mehmetalperuslu/MAXTENS/MaxTENS.step

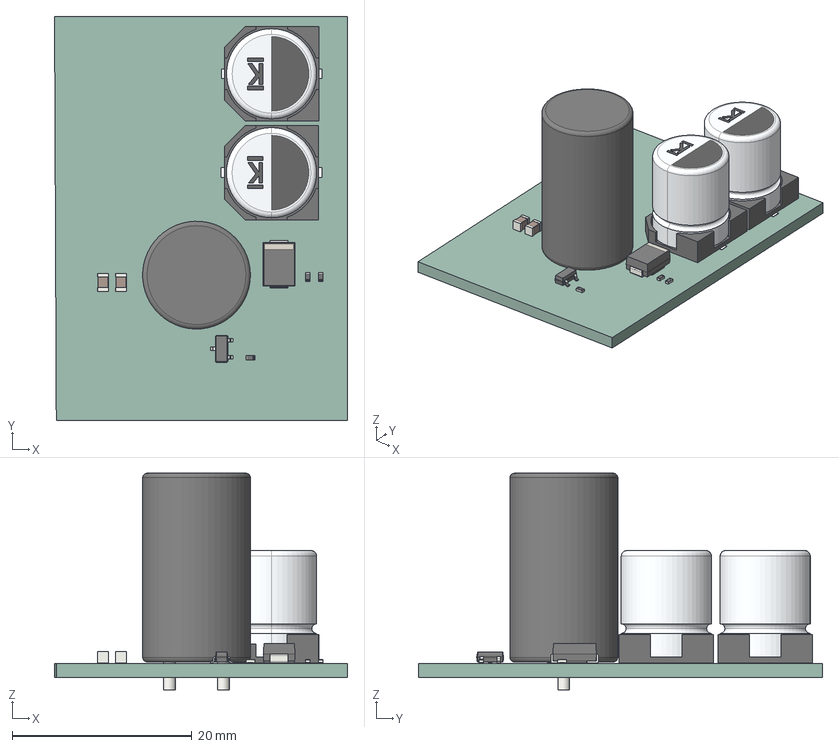
[picture p1: CAD file, 2023-09-30]
MaxTENS.step
32.6 x 45.0 x 24.1 mm
MaxTENS PCB
