mehmetalperuslu/MAXTENS/MaxTENS.kicad_pcb

## KiCad design MaxTENS.kicad_pcb (2024-05-13)

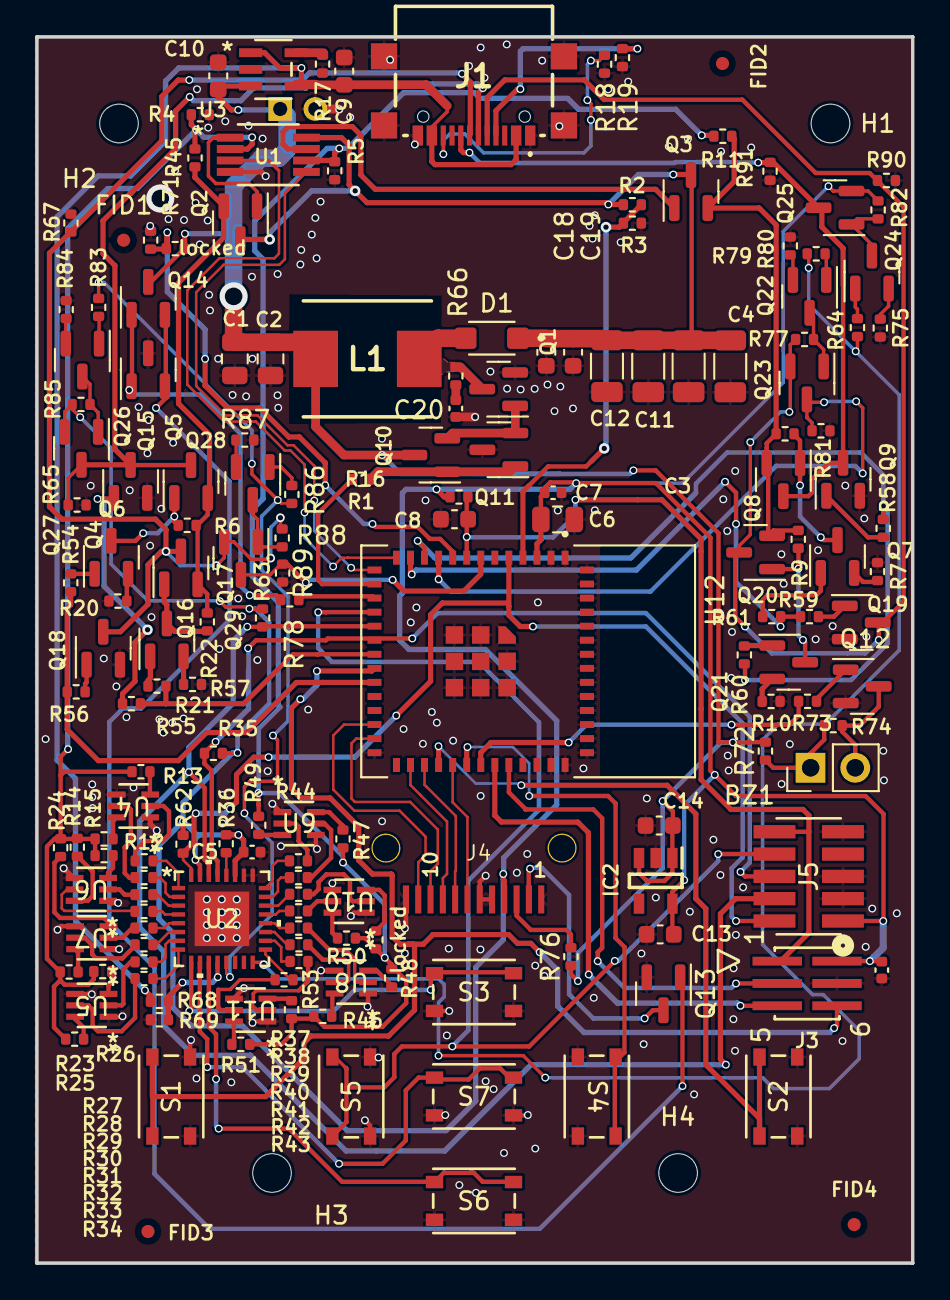
[picture p2: board MaxTENS.kicad_pcb from above]

Board: 2 copper layers, 49.9 x 69.8 mm, 174 parts (1 on the bottom side), 140 nets.

Parts:
BZ1: Buzzer; PinHeader_1x02_P2.54mm_Vertical
C1, C2: 10uF; C_0805_2012Metric
C3, C4, C11, C12: 2.2u; C_1206_3216Metric
C5, C7, C15, C20: 0.1u; C_0402_1005Metric
C6: 22u; C_0805_2012Metric
C8, C9, C10, C13, C14: 1u; C_0603_1608Metric
C18: 0.1u; C_0603_1608Metric
C19: 10n; C_0603_1608Metric
D1: DSS18UTR; SODFL3618X110N
FID1, FID2, FID3, FID4: Fiducial; Fiducial_0.75mm_Mask1.5mm
H1, H2, H3, H4: MountingHole; MountingHole_2.2mm_M2
IC2: AP7366-33W5-7; SOT95P285X130-5N
J1: GSB1C41110SSHR
J3: 20021121-00006C4LF; CONN_20021121-00006C4LF_AMP
J4: Conn_01x12; FPC_TFT_LCD
J5: 20021121-00010C4LF; CONN_00010C4LF_AMP
J6: Conn_01x02_Pin; PinHeader_1x02_P2.00mm_Vertical
L1: 22uH; INDPM7366X300N
Q1: PMV37ENEAR; SOT-23
Q2, Q3, Q4, Q6, Q7, Q9, Q10, Q12, Q14, Q16, Q18, Q19, Q21, Q22, Q24, Q26, Q28: NPN; SOT-23
Q5, Q8, Q11, Q15, Q17, Q20, Q23, Q25, Q27, Q29: PNP; SOT-23
Q13: T2N7002BK,LM; SOT-23
R1, R78: 100; R_0402_1005Metric
R2: 200k; R_0402_1005Metric
R3, R13, R16, R35, R36, R49, R62, R63, R66, R68, R69, R81, R89: 10k; R_0402_1005Metric
R4, R5: 30k; R_0402_1005Metric
R6, R8, R9, R22, R71, R77, R82, R85, R88: 100k; R_0402_1005Metric
R7, R10, R20, R21, R75, R80, R84, R87: 1k; R_0402_1005Metric
R11, R45: 16k; R_0402_1005Metric
R12, R47, R65, R67, R90, R91: 1M; R_0402_1005Metric
R14, R50: 4.99k; R_0402_1005Metric
R15: 3.3k; R_0402_1005Metric
R17, R24, R48: 2k; R_0402_1005Metric
R18, R19: 2.2k; R_0402_1005Metric
R23, R46: 2.4k; R_0402_1005Metric
R25, R51: 1.43k; R_0402_1005Metric
R26, R53: 1.1k; R_0402_1005Metric
R27, R28, R29, R30, R31, R32, R33, R34, R37, R38, R39, R40, R41, R42, R43, R44: 510; R_0402_1005Metric
R54, R55, R56, R57, R58, R59, R60, R61, R64, R79, R83, R86: 300; R_0402_1005Metric
R72, R73, R74: 1K; R_0402_1005Metric
R76: 10; R_0402_1005Metric
S1, S2, S3, S4, S5, S6, S7: PTS815 SJM 250 SMTR LFS; SW4_PTS815 SJM 250 SMTR LFS_CNK
U1: ADA4522-2ARMZ-R7
U2: PCAL6524HEAZ; HUQFN32_PCAL6524_NXP
U3: MCP73812T-420I/OT; SOT-23-5_MC_MCH
U4, U5, U6, U7, U8, U9, U10, U11: 2N7002KDW_R1_00001; SOT-363-6_2P2X1P35_ONS
U12: ESP32-MINI-1-N4; XCVR_ESP32-MINI-1-N4
locked: 3.3k; R_0402_1005Metric
locked#2: 33k; R_0402_1005Metric

Connections:
+3.3V: C5.2, C6.1, C7.1, C13.1, C15.2, IC2.5 (OUT), J3.1, J4.4, J5.1, Q25.2 (E), Q27.2 (E), R16.1, R35.1, R36.1, R62.1, R63.1, R82.2, R85.2, U2.27 (VDD(P)), U2.31 (VDD(I2C-BUS)), U12.3 (3V3)
+5V: C9.1, J1.A4 (VBUS_1), J1.A9 (VBUS_2), R68.2, U3.1 (CE), U3.4 (VDD)
+BATT: C1.1, C2.1, C10.1, C14.1, IC2.1 (IN), IC2.3 (EN), J6.1, L1.1, Q10.3 (C), Q14.3 (C), R72.2, R76.1, U3.3 (VBAT), locked#2.2
+OUT_1: Q2.2 (E), Q5.2 (E), Q17.2 (E), R6.2, R22.2, R45.1
+OUT_2: Q3.2 (E), Q8.2 (E), Q20.2 (E), R8.2, R9.2, R11.2
/BatteryCharger/BAT_CHG: R68.1, R69.2, U2.12 (P1_3)
/BatteryCharger/BAT_LEVEL: R71.2, U12.9 (I34), locked#2.1
/BatteryCharger/CH1_N: J1.A7 (DN1), Q17.3 (C), Q18.3 (C), Q29.2 (E), R67.1, R88.2
/BatteryCharger/CH1_P: J1.A6 (DP1), Q4.3 (C), Q5.3 (C), Q27.3 (C), R65.1
/BatteryCharger/CH2_N: J1.B7 (DN2), Q19.3 (C), Q20.3 (C), Q23.2 (E), R77.2, R90.1
/BatteryCharger/CH2_P: J1.B6 (DP2), Q8.3 (C), Q9.3 (C), Q25.3 (C), R91.1
/BoostConverter/VFB: R2.2, R3.1, U12.4 (I36)
/BoostConverter/VSW: R1.1, U12.15 (IO27)
/ElectrodeChannels/CH1_1: R55.2, R57.2, U12.20 (IO2)
/ElectrodeChannels/CH1_2: R54.1, R56.1, U12.22 (IO4)
/ElectrodeChannels/CH1_EL_DET: R83.1, R86.1, U2.13 (P1_4)
/ElectrodeChannels/CH2_1: R58.2, R60.2, U12.11 (IO32)
/ElectrodeChannels/CH2_2: R59.1, R61.1, U12.12 (IO33)
/ElectrodeChannels/CH2_EL_DET: R64.1, R79.1, U2.16 (P1_7)
/ElectrodeChannels/EL1_DET: Q29.3 (C), R89.1, U12.7 (I39)
/ElectrodeChannels/EL2_DET: Q23.3 (C), R81.1, U12.10 (I35)
/LCD/CLK: J4.9, U12.29 (IO5)
/LCD/CS: J4.8, U12.30 (IO18)
/LCD/DC: J4.7, U12.32 (IO19)
/LCD/DIN: J4.10, U12.26 (IO10)
/LCD/LCD_A: J4.3, R76.2
/LCD/LCD_BL: R78.1, U12.16 (IO14)
/LCD/LCD_K: J4.2, Q13.3 (D)
/LCD/RST: J4.11, U12.25 (IO9)
/MCU/BUZZER_MCU: R73.2, U12.34 (IO21)
/MCU/BUZZER_N: BZ1.2 (+), Q12.3 (C), R74.1
/MCU/BUZZER_P: BZ1.1 (-), R72.1, R74.2
/MCU/CH1_BTN: J3.5, S1.1, S1.2, U12.21 (IO0)
/MCU/CH2_BTN: S2.1, S2.2, U12.31 (IO23)
/MCU/EN: C8.2, J3.2, J5.10, R16.2, U12.8 (EN)
/MCU/IN1: U1.5 (INB+), U12.14 (IO26)
/MCU/IN2: U1.3 (INA+), U12.13 (IO25)
/MCU/INT_IO_EXP: J5.2, R62.2, U2.32 (*INT), U12.5 (I37)
/MCU/LEFT_BTN: S4.1, S4.2, U12.33 (IO22)
/MCU/MOSI: J5.4, R63.2, U2.30 (SDA), U12.18 (IO13)
/MCU/RIGHT_BTN: J5.8, S5.1, S5.2, U12.17 (IO12)
/MCU/RXD: J3.6, U12.35 (RXD0)
/MCU/SCK: J5.6, R35.2, U2.29 (SCL), U12.19 (IO15)
/MCU/TXD: J3.4, U12.36 (TXD0)
/Opamp/MODE_BTN: S6.1, S6.2, U2.11 (P1_2)
/Opamp/OK_BTN: S7.1, S7.2, U2.10 (P1_1)
/Opamp/OUTA: Q2.1 (B), U1.1 (OUTA)
/Opamp/OUTB: Q3.1 (B), U1.7 (OUTB)
/Opamp/P0W: R4.1, R12.1, R13.1, R14.1, R15.1, R23.1, R24.1, R25.1, R26.1, R45.2, U1.2 (INA-)
/Opamp/P1W: R5.1, R11.1, R46.1, R47.1, R48.1, R49.1, R50.1, R51.1, R53.1, U1.6 (INB-), locked.1
/Opamp/P05V: R27.1, U4.2 (G)
/Opamp/P010: R28.1, U4.5 (G)
/Opamp/P015: R29.1, U6.2 (G)
/Opamp/P15V: R37.1, U9.2 (G)
/Opamp/P020: R30.1, U6.5 (G)
/Opamp/P025: R31.1, U7.2 (G)
/Opamp/P030: R32.1, U7.5 (G)
/Opamp/P040: R33.1, U5.2 (G)
/Opamp/P050: R34.1, U5.5 (G)
/Opamp/P110: R38.1, U9.5 (G)
/Opamp/P115: R39.1, U10.2 (G)
/Opamp/P120: R40.1, U10.5 (G)
/Opamp/P125: R41.1, U8.2 (G)
/Opamp/P130: R42.1, U8.5 (G)
/Opamp/P140: R43.1, U11.2 (G)
/Opamp/P150: R44.1, U11.5 (G)
/Opamp/TIMER_BTN: S3.1, S3.2, U2.9 (P1_0)
GND: C1.2, C2.2, C3.2, C4.2, C5.1, C6.2, C7.2, C8.1, C9.2, C10.2, C11.2, C12.2, C13.2, C14.2, C15.1, C18.2, C19.2, C20.1, IC2.2 (GND), J1.A1 (GND_1), J1.A12 (GND_2), J1.MP1, J1.MP2, J1.MP3, J1.MP4, J3.3, J4.1, J4.5, J4.6, J4.12, J5.3, J5.5, J5.9, J6.2, Q1.2 (S), Q4.2 (E), Q9.2 (E), Q11.3 (C), Q12.2 (E), Q13.2 (S), Q15.3 (C), Q18.2 (E), Q19.2 (E), R3.2, R4.2, R5.2, R7.2, R10.2, R17.2, R18.1, R19.2, R20.2, R21.2, R65.2, R67.2, R69.1, R71.1, R75.2, R80.2, R81.2, R84.2, R87.2, R89.2, R90.2, R91.2, S1.3, S1.4, S2.3, S2.4, S3.3, S3.4, S4.3, S4.4, S5.3, S5.4, S6.3, S6.4, S7.3, S7.4, U1.4 (V-), U2.25 (VSS), U2.26 (ADDR), U2.33 (EP), U3.2 (VSS), U4.1 (S), U4.4 (S), U5.1 (S), U5.4 (S), U6.1 (S), U6.4 (S), U7.1 (S), U7.4 (S), U8.1 (S), U8.4 (S), U9.1 (S), U9.4 (S), U10.1 (S), U10.4 (S), U11.1 (S), U11.4 (S), U12.1 (GND_1), U12.2 (GND_1__1), U12.27 (GND_1__2), U12.38 (GND_1__3), U12.39 (GND_1__4), U12.40 (GND_1__5), U12.41 (GND_1__6), U12.42 (GND_1__7), U12.43 (GND_1__8), U12.44 (GND_1__9), U12.45 (GND_1__10), U12.46 (GND_1__11), U12.47 (GND_1__12), U12.48 (GND_1__13), U12.49 (GND_1__14), U12.50 (GND_2), U12.51 (GND_2__1), U12.52 (GND_2__2), U12.53 (GND_2__3), U12.54 (GND_2__4), U12.55_1 (GND_2__5), U12.55_2 (GND_2__6), U12.55_3 (GND_2__7), U12.55_4 (GND_2__8), U12.55_5 (GND_2__9), U12.55_6 (GND_2__10), U12.55_7 (GND_2__11), U12.55_8 (GND_2__12), U12.55_9 (GND_2__13)
unnamed: C20.2, R66.2
unnamed: J1.A5 (CC1), R19.1
unnamed: J1.B5 (CC2), R18.2
unnamed: D1.A, L1.2, Q1.3 (D), R66.1
unnamed: Q1.1 (G), Q10.2 (E), Q11.2 (E)
unnamed: Q4.1 (B), R55.1
unnamed: Q5.1 (B), Q6.3 (C), R6.1
unnamed: Q6.1 (B), R54.2
unnamed: Q6.2 (E), R20.1
unnamed: Q7.1 (B), R61.2
unnamed: Q7.3 (C), Q8.1 (B), R8.1
unnamed: Q7.2 (E), R7.1
unnamed: Q9.1 (B), R58.1
unnamed: Q10.1 (B), Q11.1 (B), R1.2
unnamed: Q12.1 (B), R73.1
unnamed: Q13.1 (G), Q14.2 (E), Q15.2 (E)
unnamed: Q14.1 (B), Q15.1 (B), R78.2
unnamed: Q16.1 (B), R57.1
unnamed: Q16.3 (C), Q17.1 (B), R22.1
unnamed: Q16.2 (E), R21.1
unnamed: Q18.1 (B), R56.2
unnamed: Q19.1 (B), R59.2
unnamed: Q20.1 (B), Q21.3 (C), R9.1
unnamed: Q21.1 (B), R60.1
unnamed: Q21.2 (E), R10.1
unnamed: Q22.1 (B), R79.2
unnamed: Q22.3 (C), Q23.1 (B), R77.1
unnamed: Q22.2 (E), R80.1
unnamed: Q24.1 (B), R64.2
unnamed: Q24.3 (C), Q25.1 (B), R82.1
unnamed: Q24.2 (E), R75.1
unnamed: Q26.1 (B), R83.2
unnamed: Q26.3 (C), Q27.1 (B), R85.1
unnamed: Q26.2 (E), R84.1
unnamed: Q28.1 (B), R86.2
unnamed: Q28.3 (C), Q29.1 (B), R88.1
unnamed: Q28.2 (E), R87.1
unnamed: R12.2, U4.6 (D)
unnamed: R13.2, U4.3 (D)
unnamed: R14.2, U6.6 (D)
unnamed: R15.2, U6.3 (D)
unnamed: R23.2, U7.6 (D)
unnamed: R24.2, U7.3 (D)
unnamed: R25.2, U5.6 (D)
unnamed: R26.2, U5.3 (D)
unnamed: R46.2, U8.6 (D)
unnamed: R47.2, U9.6 (D)
unnamed: R48.2, U8.3 (D)
unnamed: R49.2, U9.3 (D)
unnamed: R50.2, U10.6 (D)
unnamed: R51.2, U11.6 (D)
unnamed: U10.3 (D), locked.2
unnamed: R53.2, U11.3 (D)
unnamed: R36.2, U2.28 (*RESET)
unnamed: R27.2, U2.1 (P0_0)
unnamed: R28.2, U2.2 (P0_1)
unnamed: R29.2, U2.3 (P0_2)
unnamed: R30.2, U2.4 (P0_3)
unnamed: R31.2, U2.5 (P0_4)
unnamed: R32.2, U2.6 (P0_5)
unnamed: R33.2, U2.7 (P0_6)
unnamed: R34.2, U2.8 (P0_7)
unnamed: R44.2, U2.17 (P2_0)
unnamed: R43.2, U2.18 (P2_1)
unnamed: R42.2, U2.19 (P2_2)
unnamed: R41.2, U2.20 (P2_3)
unnamed: R40.2, U2.21 (P2_4)
unnamed: R39.2, U2.22 (P2_5)
unnamed: R38.2, U2.23 (P2_6)
unnamed: R37.2, U2.24 (P2_7)
unnamed: R17.1, U3.5 (PROG)
VCC: C3.1, C4.1, C11.1, C12.1, C18.1, C19.1, D1.C, Q2.3 (C), Q3.3 (C), R2.1, U1.8 (V+)
