mehmetalperuslu/MAXTENS/(commit log)

2023-10-20 version 2 with 0.8mm thickness
    [MainMCU.kicad_sch, MaxTENS.kicad_pcb, MaxTENS.kicad_sch, Opamp.kicad_sch, boostConverter.kicad_sch]
2023-11-05 v3: removed digital potentiometer, added 8 discrete resistors and one GPIO expander
    [MainMCU.kicad_sch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]
2023-12-23 version 4: changed GPIO expander, added current sense resistor to electrodes, added buzzer pins, fixed some gpio inputs that needs to be pulled high, added battery charge detection, added battery lev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
    [MainMCU.kicad_sch, MaxTENS.kicad_sch, Opamp.kicad_sch, batteryCharger.kicad_sch, boostConverter.kicad_sch, electrodeChannels.kicad_sch, lcd.kicad_sch]
2024-03-11 version 5: replaced ESP32-WROVER module with ESP-Mini, removed 2.5mm plugs, changed USB connector and routed electrode signals on it, added RC snubber circuit to boost converter and output caps to re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
    [MaxTENS.kicad_pcb, MaxTENS.kicad_sch, Opamp.kicad_sch, batteryCharger.kicad_sch, boostConverter.kicad_sch, electrodeChannels.kicad_sch, lcd.kicad_sch]
2024-05-13 Fixed electrode detection mechanism, modified position of USB Type-C port
    [MaxTENS.kicad_pcb, MaxTENS.kicad_sch, Opamp.kicad_sch, boostConverter.kicad_sch, electrodeChannels.kicad_sch]
